dmsc/my6502/simulator/README.md

Simulator for my6502 computer
=============================

This simulator allows testing the target firmware, should support all the
standard hardware implemented by the FPGA.

The UART is connected to the standard input/output and the VGA output is
written to an image file.
