dmsc/my6502/rtl/timer.v

/*
 * Simple 6502 computer for ice40up5k FPGA.
 *
 * (C) Daniel Serpell, <daniel.serpell@gmail.com>
 *
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
 */

// Simple 16 bit timer

module timer(
    output reg [7:0] dbr,   // Data bus READ
    input  [7:0] dbw,   // Data bus WRITE
    input  [1:0] addr,  // Address bus - two bits
    input  we,          // write/read
    input  rst,         // reset
    input  clk          // Clock
    );


    reg [15:0] counter; // Timer count
    reg active;         // Timer active
    reg shot;           // Timer reached count (reset on timer write)
    wire chip_write = we;

    // main process
    always @(posedge clk or posedge rst)
    begin
        if (rst)
        begin
            counter <= 0;
            shot <= 0;
            active <= 0;
        end
        else
        begin
            // Process writes to registers
            if (chip_write)
            begin
                // NOTE: writing to any register here will inhibit the
                //       decrementing bellow, so we loose two cycles for each
                //       counter update and one for updating the one-shot
                case(addr)
                    2'b00: counter <= counter + { 8'b0, dbw };
                    2'b01: counter <= counter + { dbw, 8'b0 };
                    2'b10:
                    begin
                        shot <= dbw[7];
                        active <= dbw[0];
                        if (dbw[0] == 0) // When timer de-activates, the count is reset to 0
                            counter <= 0;
                    end
                endcase
            end
            else
            begin
                // Process timer - only when not written
                if (active)
                begin
                    counter <= counter - 1;
                    if (counter == 0)
                        shot <= 1;
                end

                // Process reads
                case(addr)
                    2'b00: dbr <= { counter[7:0] };
                    2'b01: dbr <= { counter[15:8] };
                    2'b10: dbr <= { shot, 6'b0, active };
                endcase
            end
        end
    end

endmodule
