dmsc/my6502/rtl/upduino.v

/*
 * Simple 6502 computer for ice40up5k FPGA.
 *
 * (C) Daniel Serpell, <daniel.serpell@gmail.com>
 *
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
 */

// ICE40UP implementation details

module upduino(
    input  uart_rx,
    output uart_tx,
    output led_r,
    output led_g,
    output led_b,
    output vga_h,
    output vga_v,
    output vga_r,
    output vga_g,
    output vga_b,
    output vga_i,
    inout  spi0_mosi,
    inout  spi0_miso,
    inout  spi0_sclk,
    inout  spi0_cs0,
    inout  ps2_data,
    inout  ps2_clock,
    input  iclk
    );

    wire clk25;
    wire lock;

    // Main clock from PLL
    pll pll1(
        .clock_in(iclk),
        .clock_out(clk25),
        .locked(lock)
    );

    system #(
        .CLK_HZ(25175000)
    ) sys1 (
        .clk25(clk25),
        .rst(reset),
        .uart_tx(uart_tx),
        .uart_rx(uart_rx),
        .led_r(led_r),
        .led_g(led_g),
        .led_b(led_b),
        .spi0_mosi(spi0_mosi),
        .spi0_miso(spi0_miso),
        .spi0_sclk(spi0_sclk),
        .spi0_cs0(spi0_cs0),
        .ps2_data(ps2_data),
        .ps2_clock(ps2_clock),
        .vga_h(vga_h),
        .vga_v(vga_v),
        .vga_r(vga_r),
        .vga_g(vga_g),
        .vga_b(vga_b),
        .vga_i(vga_i)
    );

    reg [3:0] cdiv = 4'b0;
    reg reset = 1;
    always @(posedge clk25)
    begin
        if (lock)
        begin
            cdiv <= cdiv + 1;
            if(cdiv == 4'b1111)
                reset <= 0;
        end
    end

endmodule
