dmsc/my6502/simulator/src/sim65.c

/*
 * Mini65 - Small 6502 simulator with Atari 8bit bios.
 * Copyright (C) 2017-2019 Daniel Serpell
 *
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
 * You should have received a copy of the GNU General Public License along
 * with this program.  If not, see <http://www.gnu.org/licenses/>
 */
#include "sim65.h"
#include "likely.h"
#include <inttypes.h>
#include <stdarg.h>
#include <stdint.h>
#include <stdio.h>
#include <stdlib.h>
#include <string.h>

#define MAXRAM (0x10000)

// Memory status codes
#define ms_undef    1
#define ms_rom      2
#define ms_invalid  4
#define ms_callback 8

// Instruction lengths
static uint8_t ilen[256] = {
    1,2,1,1,1,2,2,1,1,2,1,1,1,3,3,1, 2,2,1,1,1,2,2,1,1,3,1,1,1,3,3,1,
    3,2,1,1,2,2,2,1,1,2,1,1,3,3,3,1, 2,2,1,1,1,2,2,1,1,3,1,1,1,3,3,1,
    1,2,1,1,1,2,2,1,1,2,1,1,3,3,3,1, 2,2,1,1,1,2,2,1,1,3,1,1,1,3,3,1,
    1,2,1,1,1,2,2,1,1,2,1,1,3,3,3,1, 2,2,1,1,1,2,2,1,1,3,1,1,1,3,3,1,
    1,2,1,1,2,2,2,1,1,1,1,1,3,3,3,1, 2,2,1,1,2,2,2,1,1,3,1,1,1,3,1,1,
    2,2,2,1,2,2,2,1,1,2,1,1,3,3,3,1, 2,2,1,1,2,2,2,1,1,3,1,1,3,3,3,1,
    2,2,1,1,2,2,2,1,1,2,1,1,3,3,3,1, 2,2,1,1,1,2,2,1,1,3,1,1,1,3,3,1,
    2,2,1,1,2,2,2,1,1,2,1,1,3,3,3,1, 2,2,1,1,1,2,2,1,1,3,1,1,1,3,3,1
};

struct sim65s
{
    enum sim65_debug debug;
    enum sim65_error error;
    enum sim65_error_lvl errlvl;
    FILE *trace_file;
    unsigned err_addr;
    uint64_t cycles;
    uint64_t cycle_limit;
    unsigned do_prof;
    struct sim65_reg r;
    uint8_t p_valid;
    uint8_t mem[MAXRAM];
    uint8_t mems[MAXRAM];
    sim65_callback cb_read[MAXRAM];
    sim65_callback cb_write[MAXRAM];
    sim65_callback cb_exec[MAXRAM];
    struct {
        unsigned exe[MAXRAM];   // Times this instruction was executed
        unsigned branch[MAXRAM];// Times this branch was taken
        unsigned branch_skip;   // Number of branches skipped
        unsigned branch_taken;  // Number of branches taken
        unsigned branch_extra;  // Extra cycles per branch to other page
        unsigned abs_x_extra;   // Extra cycles per ABS,X crossing page
        unsigned abs_y_extra;   // Extra cycles per ABS,Y crossing page
        unsigned ind_y_extra;   // Extra cycles per (),Y crossing page
        unsigned instructions;  // Number of instructions
    } prof;
    char *labels;
};

// Check if we should exit given this error, or simply log it
static int get_error_exit(sim65 s)
{
    int e = 0;
    switch (s->error)
    {
        case sim65_err_none:
            // Never exit and don't print the error
            return 0;
        case sim65_err_read_uninit:
        case sim65_err_write_rom:
            e = (s->errlvl >= sim65_errlvl_full);
            break;
        case sim65_err_exec_uninit:
        case sim65_err_read_undef:
        case sim65_err_write_undef:
            e = (s->errlvl >= sim65_errlvl_memory);
            break;
        case sim65_err_exec_undef:
        case sim65_err_break:
        case sim65_err_invalid_ins:
        case sim65_err_call_ret:
        case sim65_err_cycle_limit:
        case sim65_err_user:
            // Exit always
            return 1;
    }
    if (!e)
    {
        sim65_dprintf(s, "%s at address %04x", sim65_error_str(s, s->error),
                      s->err_addr);
        s->error = sim65_err_none;
        return 0;
    }
    else
        return s->error;
}

static char *get_label(sim65 s, uint16_t addr)
{
    if (s->labels)
        return s->labels + addr * 32;
    else
        return 0;
}

static void set_flags(sim65 s, uint8_t mask, uint8_t val)
{
    s->r.p = (s->r.p & ~mask) | val;
    s->p_valid &= ~mask;
}

static uint8_t get_flags(sim65 s, uint8_t mask)
{
    if( 0 != (s->p_valid & mask) )
        sim65_eprintf(s, "using uninitialized flags ($%02X) at PC=$%4X",
                      s->p_valid & mask, s->r.pc);
    return s->r.p & mask;
}

void sim65_set_flags(sim65 s, uint8_t flag, uint8_t val)
{
    set_flags(s, flag, val);
}

void sim65_set_cycle_limit(sim65 s, uint64_t limit)
{
    if (limit)
        s->cycle_limit = s->cycles + limit;
    else
        s->cycle_limit = 0;
}

sim65 sim65_new()
{
    sim65 s = (sim65)calloc(sizeof(struct sim65s), 1);
    s->trace_file = stderr;
    s->r.s = 0xFF;
    s->p_valid = 0xFF;
    set_flags(s, 0xFF, 0x34);
    memset(s->mems, ms_undef | ms_invalid, MAXRAM * sizeof(s->mems[0]));
    return s;
}

void sim65_free(sim65 s)
{
    free(s->labels);
    free(s);
}

void sim65_add_ram(sim65 s, unsigned addr, unsigned len)
{
    unsigned end = addr + len;
    if (addr >= MAXRAM)
        return;
    if (end >= MAXRAM)
        end = MAXRAM;
    for (; addr < end; addr++)
        s->mems[addr] &= ~ms_undef;
}

void sim65_add_zeroed_ram(sim65 s, unsigned addr, unsigned len)
{
    unsigned end = addr + len;
    if (addr >= MAXRAM)
        return;
    if (end >= MAXRAM)
        end = MAXRAM;
    for (; addr < end; addr++)
    {
        s->mems[addr] &= ~(ms_undef | ms_rom | ms_invalid);
        s->mem[addr] = 0;
    }
}

void sim65_add_data_ram(sim65 s, unsigned addr, const unsigned char *data, unsigned len)
{
    unsigned end = addr + len;
    if (addr >= MAXRAM)
        return;
    if (end >= MAXRAM)
        end = MAXRAM;
    for (; addr < end; addr++, data++)
    {
        s->mems[addr] &= ~(ms_undef | ms_rom | ms_invalid);
        s->mem[addr] = *data;
    }
}

void sim65_add_data_rom(sim65 s, unsigned addr, const unsigned char *data, unsigned len)
{
    unsigned end = addr + len;
    if (addr >= MAXRAM)
        return;
    if (end >= MAXRAM)
        end = MAXRAM;
    for (; addr < end; addr++, data++)
    {
        s->mems[addr] &= ~(ms_undef | ms_invalid);
        s->mems[addr] |= ms_rom;
        s->mem[addr] = *data;
    }
}

void sim65_add_callback(sim65 s, unsigned addr, sim65_callback cb, enum sim65_cb_type type)
{
    if (addr >= MAXRAM)
        return;
    s->mems[addr] |= ms_callback;
    switch (type)
    {
        case sim65_cb_read:
            s->cb_read[addr] = cb;
            break;
        case sim65_cb_write:
            s->cb_write[addr] = cb;
            break;
        case sim65_cb_exec:
            s->cb_exec[addr] = cb;
            break;
    }
}

void sim65_add_callback_range(sim65 s, unsigned addr, unsigned len, sim65_callback cb,
                              enum sim65_cb_type type)
{
    unsigned i;
    for (i = addr; i < addr + len && i < MAXRAM; i++)
        sim65_add_callback(s, i, cb, type);
}

unsigned sim65_get_byte(sim65 s, unsigned addr)
{
    if (addr >= MAXRAM)
        return 0x100;
    if (s->mems[addr] & ms_invalid)
        return 0x100;
    return s->mem[addr];
}

uint8_t *sim65_get_pbyte(sim65 s, unsigned addr)
{
    if (addr >= MAXRAM)
        return 0;
    return & s->mem[addr];
}

void set_error(sim65 s, int e, uint16_t addr)
{
    if (e < 0 && !s->error)
    {
        s->error = (enum sim65_error)e;
        s->err_addr = addr;
    }
}

static uint8_t readPc_slow(sim65 s, uint16_t addr)
{
    if (s->mems[addr] & ms_undef)
        set_error(s, sim65_err_exec_undef, addr);
    else
        set_error(s, sim65_err_exec_uninit, addr);
    return s->mem[addr];
}

static inline uint8_t readPc(sim65 s, unsigned offset)
{
    uint16_t addr = s->r.pc + offset;
    return likely(!(s->mems[addr] & ~(ms_rom | ms_callback))) ?
           s->mem[addr] : readPc_slow(s, addr);
}

static uint8_t readByte_slow(sim65 s, uint16_t addr)
{
    // Unusual memory
    if ((s->mems[addr] & ms_callback) && s->cb_read[addr])
    {
        int e = s->cb_read[addr](s, &s->r, addr, sim65_cb_read);
        set_error(s, e, addr);
        return e;
    }
    else
    {
        if (s->mems[addr] & ms_undef)
            set_error(s, sim65_err_read_undef, addr);
        else
        {
            set_error(s, sim65_err_read_uninit, addr);
            s->mems[addr] &= ~ms_invalid; // Initializes the memory
        }
        return s->mem[addr];
    }
}

static inline uint8_t readByte(sim65 s, uint16_t addr)
{
    return likely(!(s->mems[addr] & ~ms_rom)) ? s->mem[addr] : readByte_slow(s, addr);
}

static void writeByte_slow(sim65 s, uint16_t addr, uint8_t val)
{
    if (likely(!(s->mems[addr] & ~ms_invalid)))
    {
        s->mem[addr] = val;
        s->mems[addr] = 0;
    }
    else if ((s->mems[addr] & ms_callback) && s->cb_write[addr])
        set_error(s, s->cb_write[addr](s, &s->r, addr, val), addr);
    else if (s->mems[addr] & ms_undef)
        set_error(s, sim65_err_write_undef, addr);
    else if (s->mems[addr] & ms_rom)
        set_error(s, sim65_err_write_rom, addr);
}

static inline void writeByte(sim65 s, uint16_t addr, uint8_t val)
{
    if (likely(!(s->mems[addr])))
        s->mem[addr] = val;
    else
        writeByte_slow(s, addr, val);
}

static inline uint16_t readWord(sim65 s, uint16_t addr)
{
    uint16_t d1 = readByte(s, addr);
    return d1 | (readByte(s, addr + 1) << 8);
}

static uint8_t readIndX(sim65 s, unsigned addr)
{
    s->cycles += 6;
    addr = readWord(s, (addr + s->r.x) & 0xFF);
    return readByte(s, addr);
}

static int readIndY(sim65 s, unsigned addr)
{
    s->cycles += 5;
    addr = readWord(s, addr & 0xFF);
    if (unlikely(((addr & 0xFF) + s->r.y) > 0xFF))
    {
        s->cycles++;
        if (s->do_prof)
            s->prof.ind_y_extra ++;
    }
    return readByte(s, 0xFFFF & (addr + s->r.y));
}

static void writeIndX(sim65 s, unsigned addr, unsigned val)
{
    s->cycles += 6;
    addr = readWord(s, (addr + s->r.x) & 0xFF);
    writeByte(s, addr, val);
}

static void writeIndY(sim65 s, unsigned addr, unsigned val)
{
    s->cycles += 6;
    addr = readWord(s, addr & 0xFF);
    writeByte(s, 0xFFFF & (addr + s->r.y), val);
}

#define FLAG_C SIM65_FLAG_C
#define FLAG_Z SIM65_FLAG_Z
#define FLAG_I SIM65_FLAG_I
#define FLAG_D SIM65_FLAG_D
#define FLAG_B SIM65_FLAG_B
#define FLAG_V SIM65_FLAG_V
#define FLAG_N SIM65_FLAG_N

#define SETZ(a) set_flags(s, FLAG_Z,  (a)&0xFF ? 0 : FLAG_Z)
#define SETC(a) set_flags(s, FLAG_C,  (a) ? FLAG_C : 0)
#define SETV(a) set_flags(s, FLAG_V,  (a) ? FLAG_V : 0)
#define SETD(a) set_flags(s, FLAG_D,  (a) ? FLAG_D : 0)
#define SETN(a) set_flags(s, FLAG_N,  (a)&0x80 ? FLAG_N : 0)
#define SETI(a) set_flags(s, FLAG_I,  (a) ? FLAG_I : 0)
#define GETC    get_flags(s, FLAG_C)
#define GETD    get_flags(s, FLAG_D)

// Implements ADC instruction, adding the accumulator with the given value.
static void do_adc(sim65 s, unsigned val)
{
    if (GETD)
    {
        // Decimal mode:
        // Z flag is computed as the binary version.
        unsigned tmp = s->r.a + val + (GETC ? 1 : 0);
        SETZ(tmp);
        // ADC value is computed in decimal
        tmp = (s->r.a & 0xF) + (val & 0xF) + (GETC ? 1 : 0);
        if (tmp >= 10)
            tmp = (tmp - 10) | 16;
        tmp += (s->r.a & 0xF0) + (val & 0xF0);
        SETN(tmp);
        SETV(!((s->r.a ^ val) & 0x80) && ((val ^ tmp) & 0x80));
        if (tmp > 0x9F)
            tmp += 0x60;
        SETC(tmp > 0xFF);
        s->r.a = tmp & 0xFF;
    }
    else
    {
        // Binary mode
        unsigned tmp = s->r.a + val + (GETC ? 1 : 0);
        SETV(((~(s->r.a ^ val)) & (s->r.a ^ tmp)) & 0x80);
        //  SETV(!((s->r.a ^ val) & 0x80) && ((val ^ tmp) & 0x80));
        SETC(tmp > 0xFF);
        SETN(tmp);
        SETZ(tmp);
        s->r.a = tmp & 0xFF;
    }
}

// Implements SBC instruction, subtract the accumulator to the given value.
static void do_sbc(sim65 s, unsigned val)
{
    if (GETD)
    {
        // Decimal mode:
        val = val ^ 0xFF;

        // Z and V flags computed as the binary version.
        unsigned tmp = s->r.a + val + (GETC ? 1 : 0);
        SETV((((s->r.a ^ val)) & (s->r.a ^ tmp)) & 0x80);
        SETZ(tmp);

        // ADC value is computed in decimal
        tmp = (s->r.a & 0xF) + (val & 0xF) + (GETC ? 1 : 0);
        if (tmp < 0x10)
            tmp = (tmp - 6) & 0x0F;

        tmp += (s->r.a & 0xF0) + (val & 0xF0);
        if (tmp < 0x100)
            tmp = (tmp - 0x60) & 0xFF;

        SETN(tmp);
        SETC(tmp > 0xFF);
        s->r.a = tmp & 0xFF;
    }
    else
    {
        // Binary mode
        unsigned tmp = s->r.a + 0xFF - val + (GETC ? 1 : 0);
        SETV((((s->r.a ^ val)) & (s->r.a ^ tmp)) & 0x80);
        SETC(tmp > 0xFF);
        SETN(tmp);
        SETZ(tmp);
        s->r.a = tmp & 0xFF;
    }
}

// Implements branch instructions
static void do_branch(sim65 s, int8_t off, uint8_t mask, int cond)
{
    s->cycles += 2;
    if (!get_flags(s, mask) == !cond)
    {
        s->cycles++;
        if (s->do_prof)
        {
            s->prof.branch[(s->r.pc-2) & 0xFFFF] ++;
            s->prof.branch_taken ++;
        }
        uint16_t val = (s->r.pc + off) & 0xFFFF;
        if ((val & 0xFF00) != (s->r.pc & 0xFF00))
        {
            s->cycles++;
            if (s->do_prof)
                s->prof.branch_extra ++;
        }
        s->r.pc = val;
    }
    else if (s->do_prof)
        s->prof.branch_skip ++;
}

static void do_extra_absx(sim65 s, unsigned addr)
{
    if (((addr & 0xFF) + s->r.x) > 0xFF)
    {
        s->cycles++;
        if (s->do_prof)
            s->prof.abs_x_extra ++;
    }
}

static void do_extra_absy(sim65 s, unsigned addr)
{
    if (((addr & 0xFF) + s->r.y) > 0xFF)
    {
        s->cycles++;
        if (s->do_prof)
            s->prof.abs_y_extra ++;
    }
}

#define ZP_R1   val = readByte(s, data & 0xFF)
#define ZP_W1   writeByte(s, data & 0xFF, val)
#define ZPX_R1  val = readByte(s, (data + s->r.x) & 0xFF)
#define ZPX_W1  writeByte(s, (data + s->r.x) & 0xFF, val)
#define ZPY_R1  val = readByte(s, (data + s->r.y) & 0xFF)
#define ZPY_W1  writeByte(s, (data + s->r.y) & 0xFF, val)
#define ABS_R1  val = readByte(s, data)
#define ABS_W1  writeByte(s, data, val)
#define ABX_R1  val = readByte(s, data + s->r.x)
#define ABX_W1  writeByte(s, data + s->r.x, val)
#define ABY_R1  val = readByte(s, data + s->r.y)
#define ABY_W1  writeByte(s, data + s->r.y, val)
#define IND_X(op)  val = readIndX(s, data); op
#define IND_Y(op)  val = readIndY(s, data); op
#define INDW_X(op) op; writeIndX(s, data, val)
#define INDW_Y(op) op; writeIndY(s, data, val)

#define ORA s->r.a |= val; SETZ(s->r.a); SETN(s->r.a)
#define AND s->r.a &= val; SETZ(s->r.a); SETN(s->r.a)
#define EOR s->r.a ^= val; SETZ(s->r.a); SETN(s->r.a)
#define ADC do_adc(s, val)
#define SBC do_sbc(s, val)
#define ASL SETC(val & 0x80); val = (val << 1) & 0xFF; SETZ(val); SETN(val)
#define ROL val = (val << 1) | (GETC ? 1 : 0); SETC(val & 256); val &= 0xFF; SETZ(val); SETN(val)
#define LSR SETC(val & 1); val=(val >> 1) & 0xFF; SETZ(val); SETN(val)
#define ROR val |= (GETC ? 256 : 0); SETC(val & 1); val = (val >> 1) & 0xFF; SETZ(val); SETN(val)

#define SET_ZN   SETN(val); SETZ(val)
#define DEC val = (val - 1) & 0xFF; SET_ZN
#define INC val = (val + 1) & 0xFF; SET_ZN
#define CMP val = (s->r.a + 0x100 - val); SET_ZN; SETC(val > 0xFF)
#define CPX val = (s->r.x + 0x100 - val); SET_ZN; SETC(val > 0xFF)
#define CPY val = (s->r.y + 0x100 - val); SET_ZN; SETC(val > 0xFF)

#define LDA SET_ZN; s->r.a = val
#define LDX SET_ZN; s->r.x = val
#define LDY SET_ZN; s->r.y = val
#define STA val = s->r.a
#define STX val = s->r.x
#define STY val = s->r.y
#define PUSH(val) s->cycles += 3; writeByte(s, 0x100 + s->r.s,val); s->r.s = (s->r.s - 1) & 0xFF
#define POP  s->r.s = (s->r.s + 1) & 0xFF; val = readByte(s, 0x100 + s->r.s)

// Complete ops
#define ZP_R(op)   s->cycles += 3; ZP_R1; op
#define ZP_W(op)   s->cycles += 3; op; ZP_W1
#define ZP_RW(op)  s->cycles += 5; ZP_R1; op; ZP_W1

#define ABS_R(op)  s->cycles += 4; ABS_R1; op
#define ABS_W(op)  s->cycles += 4; op; ABS_W1
#define ABS_RW(op) s->cycles += 6; ABS_R1; op; ABS_W1

#define ZPX_R(op)   s->cycles += 4; ZPX_R1; op
#define ZPX_W(op)   s->cycles += 4; op; ZPX_W1
#define ZPX_RW(op)  s->cycles += 6; ZPX_R1; op; ZPX_W1

#define ZPY_R(op)   s->cycles += 4; ZPY_R1; op
#define ZPY_W(op)   s->cycles += 4; op; ZPY_W1

#define ABX_R(op)   s->cycles += 4; do_extra_absx(s, data); ABX_R1; op
#define ABX_W(op)   s->cycles += 5; op; ABX_W1
#define ABX_RW(op)  s->cycles += 7; ABX_R1; op; ABX_W1

#define ABY_R(op)   s->cycles += 4; do_extra_absy(s, data); ABY_R1; op
#define ABY_W(op)   s->cycles += 5; op; ABY_W1

#define IMM(op)     s->cycles += 2; val = data; op
#define IMP_A(op)   s->cycles += 2; val = s->r.a; op; s->r.a = val; SET_ZN
#define IMP_Y(op)   s->cycles += 2; val = s->r.y; op; s->r.y = val; SET_ZN
#define IMP_X(op)   s->cycles += 2; val = s->r.x; op; s->r.x = val; SET_ZN
#define TXS(op)     s->cycles += 2; s->r.s = s->r.x;

#define BRA_0(a)    do_branch(s, data, a, 0)
#define BRA_1(a)    do_branch(s, data, a, 1)
#define JMP()      s->cycles += 3; s->r.pc = data
#define JMP16()    s->cycles += 5; s->r.pc = readWord(s, data)
#define JSR()      do_jsr(s, data)
#define RTS()      do_rts(s)
#define RTI()      do_rti(s)

#define CL_F(f)   s->cycles += 2; set_flags(s, f, 0)
#define SE_F(f)   s->cycles += 2; set_flags(s, f, f)

#define POP_P  s->cycles += 4; POP; set_flags(s, 0xFF, val | 0x30)
#define POP_A  s->cycles += 4; POP; LDA

// Special case BIT instructions as sometimes are used to SKIP
void do_bit(sim65 s, uint16_t addr)
{
    if ((s->mems[addr] & ms_invalid) && !(s->mems[addr] & ms_callback))
        s->p_valid |= (FLAG_N | FLAG_V | FLAG_Z);
    else
    {
        uint8_t val = readByte(s, addr);
        SETN(val);
        SETV(val & 0x40);
        SETZ(s->r.a & val);
    }
}
#define BIT_ZP   s->cycles += 3; do_bit(s, data & 0xFF)
#define BIT_ABS  s->cycles += 4; do_bit(s, data)

static void do_jsr(sim65 s, unsigned data)
{
    s->r.pc = (s->r.pc - 1) & 0xFFFF;
    PUSH(s->r.pc >> 8);
    PUSH(s->r.pc);
    s->r.pc = data;
}

static void do_rts(sim65 s)
{
    unsigned val;
    POP;
    s->r.pc = val;
    POP;
    s->r.pc |= val << 8;
    s->r.pc = (s->r.pc + 1) & 0xFFFF;
    s->cycles += 6;
}

static void do_rti(sim65 s)
{
    unsigned val;
    POP_P; // NOTE: already adds 4 cycles
    POP;
    s->r.pc = val;
    POP;
    s->r.pc |= val << 8;
    s->r.pc = (s->r.pc) & 0xFFFF;
    s->cycles += 2;
}

static void next(sim65 s)
{
    unsigned ins, data, val, old_pc = 0, old_cycles = 0;

    // See if out vector
    if (s->cb_exec[s->r.pc])
    {
        set_error(s, s->cb_exec[s->r.pc](s, &s->r, s->r.pc, sim65_cb_exec), s->r.pc);
        if (get_error_exit(s))
            return;
    }

    if (s->debug >= sim65_debug_trace)
        sim65_print_reg(s, s->trace_file);

    if (s->cycle_limit && s->cycles >= s->cycle_limit)
    {
        set_error(s, sim65_err_cycle_limit, s->r.pc);
        return;
    }

    // Read instruction and data
    ins = readPc(s, 0);
    if (ilen[ins] > 1)
        data = readPc(s, 1);

    if (ilen[ins] > 2)
        data |= readPc(s, 2) << 8;

    // If profiling, store old info
    if (s->do_prof)
    {
        old_pc = s->r.pc;
        old_cycles = s->cycles;
    }
    // Update PC
    s->r.pc += ilen[ins];

    switch (ins)
    {
        case 0x00:  set_error(s, sim65_err_break, s->r.pc - 1); break;
        case 0x01:  IND_X(ORA);             break;
        case 0x05:  ZP_R(ORA);              break;
        case 0x06:  ZP_RW(ASL);             break;
        case 0x08:  PUSH(get_flags(s,0xFF)); break; // PHP
        case 0x09:  IMM(ORA);               break;
        case 0x0A:  IMP_A(ASL);             break;
        case 0x0D:  ABS_R(ORA);             break;
        case 0x0E:  ABS_RW(ASL);            break;
        case 0x10:  BRA_0(FLAG_N);          break; // BPL
        case 0x11:  IND_Y(ORA);             break;
        case 0x15:  ZPX_R(ORA);             break;
        case 0x16:  ZPX_RW(ASL);            break;
        case 0x18:  CL_F(FLAG_C);           break; // CLC
        case 0x19:  ABY_R(ORA);             break;
        case 0x1d:  ABX_R(ORA);             break;
        case 0x1e:  ABX_RW(ASL);            break;
        case 0x20:  JSR();                  break; // JSR
        case 0x21:  IND_X(AND);             break;
        case 0x24:  BIT_ZP;                 break;
        case 0x25:  ZP_R(AND);              break;
        case 0x26:  ZP_RW(ROL);             break;
        case 0x28:  POP_P;                  break; // PLP
        case 0x29:  IMM(AND);               break;
        case 0x2a:  IMP_A(ROL);             break;
        case 0x2c:  BIT_ABS;                break;
        case 0x2d:  ABS_R(AND);             break;
        case 0x2e:  ABS_RW(ROL);            break;
        case 0x30:  BRA_1(FLAG_N);          break;
        case 0x31:  IND_Y(AND);             break;
        case 0x35:  ZPX_R(AND);             break;
        case 0x36:  ZPX_RW(ROL);            break;
        case 0x38:  SE_F(FLAG_C);           break; // SEC
        case 0x39:  ABY_R(AND);             break;
        case 0x3d:  ABX_R(AND);             break;
        case 0x3e:  ABX_RW(ROL);            break;
        case 0x40:  RTI();                  break; // RTI
        case 0x41:  IND_X(EOR);             break;
        case 0x45:  ZP_R(EOR);              break;
        case 0x46:  ZP_RW(LSR);             break;
        case 0x48:  PUSH(s->r.a);           break; // PHA
        case 0x49:  IMM(EOR);               break;
        case 0x4a:  IMP_A(LSR);             break;
        case 0x4c:  JMP();                  break; // JMP
        case 0x4d:  ABS_R(EOR);             break;
        case 0x4e:  ABS_RW(LSR);            break;
        case 0x50:  BRA_0(FLAG_V);          break;
        case 0x51:  IND_Y(EOR);             break;
        case 0x55:  ZPX_R(EOR);             break;
        case 0x56:  ZPX_RW(LSR);            break;
        case 0x58:  CL_F(FLAG_I);           break; // CLI
        case 0x59:  ABY_R(EOR);             break;
        case 0x5d:  ABX_R(EOR);             break;
        case 0x5e:  ABX_RW(LSR);            break;
        case 0x60:  RTS();                  break; // RTS
        case 0x61:  IND_X(ADC);             break;
        case 0x65:  ZP_R(ADC);              break;
        case 0x66:  ZP_RW(ROR);             break;
        case 0x68:  POP_A;                  break; // PLA
        case 0x69:  IMM(ADC);               break;
        case 0x6a:  IMP_A(ROR);             break;
        case 0x6c:  JMP16();                break; // JMP ()
        case 0x6d:  ABS_R(ADC);             break;
        case 0x6e:  ABS_RW(ROR);            break;
        case 0x70:  BRA_1(FLAG_V);          break;
        case 0x71:  IND_Y(ADC);             break;
        case 0x75:  ZPX_R(ADC);             break;
        case 0x76:  ZPX_RW(ROR);            break;
        case 0x78:  SE_F(FLAG_I);           break; // SEI
        case 0x79:  ABY_R(ADC);             break;
        case 0x7d:  ABX_R(ADC);             break;
        case 0x7e:  ABX_RW(ROR);            break;
        case 0x81:  INDW_X(STA);            break;
        case 0x84:  ZP_W(STY);              break;
        case 0x85:  ZP_W(STA);              break;
        case 0x86:  ZP_W(STX);              break;
        case 0x88:  IMP_Y(DEC);             break; // DEY
        case 0x8a:  IMP_X(LDA);             break; // TXA
        case 0x8c:  ABS_W(STY);             break;
        case 0x8d:  ABS_W(STA);             break;
        case 0x8e:  ABS_W(STX);             break;
        case 0x90:  BRA_0(FLAG_C);          break; // BCC
        case 0x91:  INDW_Y(STA);            break;
        case 0x94:  ZPX_W(STY);             break;
        case 0x95:  ZPX_W(STA);             break;
        case 0x96:  ZPY_W(STX);             break;
        case 0x98:  IMP_Y(LDA);             break; // TYA
        case 0x99:  ABY_W(STA);             break;
        case 0x9a:  TXS();                  break; // TXS
        case 0x9d:  ABX_W(STA);             break;
        case 0xa0:  IMM(LDY);               break;
        case 0xa1:  IND_X(LDA);             break;
        case 0xa2:  IMM(LDX);               break;
        case 0xa4:  ZP_R(LDY);              break;
        case 0xa5:  ZP_R(LDA);              break;
        case 0xa6:  ZP_R(LDX);              break;
        case 0xa8:  IMP_A(LDY);             break; // TAY
        case 0xa9:  IMM(LDA);               break;
        case 0xaa:  IMP_A(LDX);             break; // TAX
        case 0xac:  ABS_R(LDY);             break;
        case 0xad:  ABS_R(LDA);             break;
        case 0xae:  ABS_R(LDX);             break;
        case 0xb0:  BRA_1(FLAG_C);          break; // BCS
        case 0xb1:  IND_Y(LDA);             break;
        case 0xb4:  ZPX_R(LDY);             break;
        case 0xb5:  ZPX_R(LDA);             break;
        case 0xb6:  ZPY_R(LDX);             break;
        case 0xb8:  CL_F(FLAG_V);           break; // CLV
        case 0xb9:  ABY_R(LDA);             break;
        case 0xba:  IMP_X(val = s->r.s);    break; // TSX
        case 0xbc:  ABX_R(LDY);             break;
        case 0xbd:  ABX_R(LDA);             break;
        case 0xbe:  ABY_R(LDX);             break;
        case 0xc0:  IMM(CPY);               break;
        case 0xc1:  IND_X(CMP);             break;
        case 0xc4:  ZP_R(CPY);              break;
        case 0xc5:  ZP_R(CMP);              break;
        case 0xc6:  ZP_RW(DEC);             break;
        case 0xc8:  IMP_Y(INC);             break; // INY
        case 0xc9:  IMM(CMP);               break;
        case 0xca:  IMP_X(DEC);             break; // DEX
        case 0xcc:  ABS_R(CPY);             break;
        case 0xcd:  ABS_R(CMP);             break;
        case 0xce:  ABS_RW(DEC);            break;
        case 0xd0:  BRA_0(FLAG_Z);          break; // BNE
        case 0xd1:  IND_Y(CMP);             break;
        case 0xd5:  ZPX_R(CMP);             break;
        case 0xd6:  ZPX_RW(DEC);            break;
        case 0xd8:  CL_F(FLAG_D);           break; // CLD
        case 0xd9:  ABY_R(CMP);             break;
        case 0xdd:  ABX_R(CMP);             break;
        case 0xde:  ABX_RW(DEC);            break;
        case 0xe0:  IMM(CPX);               break;
        case 0xe1:  IND_X(SBC);             break;
        case 0xe4:  ZP_R(CPX);              break;
        case 0xe5:  ZP_R(SBC);              break;
        case 0xe6:  ZP_RW(INC);             break;
        case 0xe8:  IMP_X(INC);             break; // INX
        case 0xe9:  IMM(SBC);               break;
        case 0xea:  s->cycles += 2;         break; // NOP
        case 0xec:  ABS_R(CPX);             break;
        case 0xed:  ABS_R(SBC);             break;
        case 0xee:  ABS_RW(INC);            break;
        case 0xf0:  BRA_1(FLAG_Z);          break; // BEQ
        case 0xf1:  IND_Y(SBC);             break;
        case 0xf5:  ZPX_R(SBC);             break;
        case 0xf6:  ZPX_RW(INC);            break;
        case 0xf8:  SE_F(FLAG_D);           break; // SED
        case 0xf9:  ABY_R(SBC);             break;
        case 0xfd:  ABX_R(SBC);             break;
        case 0xfe:  ABX_RW(INC);            break;
        default:    set_error(s, sim65_err_invalid_ins, s->r.pc - 1);
    }
    // Update profile information
    if (s->do_prof)
    {
        s->prof.instructions ++;
        s->prof.exe[old_pc & 0xFFFF] += s->cycles -old_cycles;
    }
}

enum sim65_error sim65_run(sim65 s, struct sim65_reg *regs, unsigned addr)
{
    if (regs)
        memcpy(&s->r, regs, sizeof(*regs));

    s->error = sim65_err_none;
    s->r.pc = addr;
    while (!get_error_exit(s))
        next(s);

    if (regs)
        memcpy(regs, &s->r, sizeof(*regs));

    return s->error;
}

// Called on return from simulated code
static int sim65_rts_callback(sim65 s, struct sim65_reg *regs,
                              unsigned addr, int data)
{
    return (int)sim65_err_call_ret;
}

// Calls the emulator at given code, ends on RTS
enum sim65_error sim65_call(sim65 s, struct sim65_reg *regs, unsigned addr)
{
    // Setup registers if given
    if (regs)
        memcpy(&s->r, regs, sizeof(*regs));

    // Save original PC
    unsigned old_pc = s->r.pc;

    // Use 0 as return address
    s->r.pc = 0;
    sim65_add_callback(s, 0, sim65_rts_callback, sim65_cb_exec);

    // Execute a JSR
    do_jsr(s, addr);

    // And continue the emulator
    enum sim65_error err = sim65_run(s, 0, addr);

    // If we got from a JSR return, simply return ok
    if (err == sim65_err_call_ret)
    {
        // Now, return to old address
        s->r.pc = old_pc;
        err = s->error = sim65_err_none;
    }

    return err;
}

void sim65_set_debug(sim65 s, enum sim65_debug level)
{
    s->debug = level;
}

void sim65_set_trace_file(sim65 s, FILE *f)
{
    if (f)
        s->trace_file = f;
    else
        s->trace_file = stderr;
}

void sim65_set_error_level(sim65 s, enum sim65_error_lvl level)
{
    s->errlvl = level;
}

// --------------------------------------------------------------------
// Trace printing functions
// --------------------------------------------------------------------
static const char *hex_digits = "0123456789ABCDEF";
static char *hex2(char *c, uint8_t x)
{
    c[0] = hex_digits[x >> 4];
    c[1] = hex_digits[x & 15];
    return c + 2;
}

static char *hex4(char *c, uint16_t x)
{
    c[0] = hex_digits[x >> 12];
    c[1] = hex_digits[(x >> 8) & 15];
    c[2] = hex_digits[(x >> 4) & 15];
    c[3] = hex_digits[x & 15];
    return c + 4;
}

static char *hex8(char *c, uint32_t x)
{
    c[0] = hex_digits[(x >> 28) & 15];
    c[1] = hex_digits[(x >> 24) & 15];
    c[2] = hex_digits[(x >> 20) & 15];
    c[3] = hex_digits[(x >> 16) & 15];
    c[4] = hex_digits[(x >> 12) & 15];
    c[5] = hex_digits[(x >> 8) & 15];
    c[6] = hex_digits[(x >> 4) & 15];
    c[7] = hex_digits[x & 15];
    return c + 8;
}

static void print_mem(char *buf, sim65 s, unsigned addr)
{
    addr &= 0xFFFF;
    if (!(s->mems[addr] & ms_invalid))
    {
        if (!(s->mems[addr] & ms_rom))
        {
            buf[0] = '[';
            hex2(buf + 1, s->mem[addr]);
            buf[3] = ']';
            buf[4] = 0;
        }
        else
        {
            buf[0] = '{';
            hex2(buf + 1, s->mem[addr]);
            buf[3] = '}';
            buf[4] = 0;
        }
    }
    else if (s->mems[addr] & ms_undef)
        memcpy(buf, "[UU]", 4);
    else
        memcpy(buf, "[NN]", 4);
}

static void print_mem_count(char *buf, sim65 s, unsigned addr, unsigned len)
{
    unsigned i;
    for (i = 0; i < len; i++)
        print_mem(buf + i * 4, s, addr + i);
}

static char *print_lbl_max(char *buf, char *lbl, int max)
{
    int ln = strlen(lbl);
    if (ln > max)
    {
        *buf++ = '?';
        memcpy(buf, lbl + ln - max + 1, max - 1);
        buf += max - 1;
    }
    else
    {
        memcpy(buf, lbl, ln);
        buf += ln;
    }
    return buf;
}

static char *print_abs_label(sim65 s, char *buf, uint16_t addr, char idx)
{
    char *l = get_label(s, addr);
    if (l && *l)
        buf = print_lbl_max(buf, l, 24);
    else
    {
        *buf++ = '$';
        buf = hex4(buf, addr);
    }
    if (idx)
    {
        *buf++ = ',';
        *buf++ = idx;
    }
    return buf;
}

static char *print_zp_label(sim65 s, char *buf, uint16_t addr, char idx)
{
    char *l = get_label(s, addr);
    if (l && *l)
        buf = print_lbl_max(buf, l, 24);
    else
    {
        *buf++ = '$';
        buf = hex2(buf, addr);
    }
    if (idx)
    {
        *buf++ = ',';
        *buf++ = idx;
    }
    return buf;
}

static char *print_ind_label(sim65 s, char *buf, uint16_t addr, char idx, int hint)
{
    char *l = get_label(s, addr);
    *buf++ = '(';
    if (l && *l)
        buf = print_lbl_max(buf, l, 14);
    else
    {
        *buf++ = '$';
        if (idx)
            buf = hex2(buf, addr);
        else
            buf = hex4(buf, addr);
    }
    if (idx == 'Y')
        *buf++ = ')';

    if (idx)
    {
        *buf++ = ',';
        *buf++ = idx;
    }

    if (idx != 'Y')
        *buf++ = ')';

    if (hint)
    {
        *buf++ = ' ';
        *buf++ = '[';
        *buf++ = '$';

        if (idx == 'X')
            buf = hex4(buf, readWord(s, 0xFF & (addr + s->r.x)));
        else if (idx == 'Y')
            buf = hex4(buf, readWord(s, addr) + s->r.y);
        else
            buf = hex4(buf, readWord(s, addr));
        *buf++ = ']';
    }

    return buf;
}

#define PSTR(str) memcpy(buf, str, strlen(str)); buf += strlen(str)
#define PHX2(val) buf = hex2(buf, val)
#define PHX4(val) buf = hex4(buf, val)
#define PNAM(name)  PSTR(name); buf++;
#define PLAB(val)  buf = print_abs_label(s, buf, val, 0)
#define PLABX(val) buf = print_abs_label(s, buf, val, 'X')
#define PLABY(val) buf = print_abs_label(s, buf, val, 'Y')
#define PLZP(val)  buf = print_zp_label(s, buf, val, 0)
#define PLZPX(val) buf = print_zp_label(s, buf, val, 'X')
#define PLZPY(val) buf = print_zp_label(s, buf, val, 'Y')
#define PLIDX(val) buf = print_ind_label(s, buf, val, 'X', hint)
#define PLIDY(val) buf = print_ind_label(s, buf, val, 'Y', hint)
#define PLIND(val) buf = print_ind_label(s, buf, val, 0, hint)
#define PXTRA(b,r,h) if (h) buf[18] = ((((b)+(r))^(b))&0xFF00) ? '*' : buf[18]

#define INSPRT_IMM(name) PNAM(name); PSTR("#$"); PHX2(data)
#define INSPRT_BRA(name) PNAM(name); PXTRA(pc+2, (int8_t)(data), 1); PLAB(pc+2+(int8_t)data)
#define INSPRT_ABS(name) PNAM(name); PLAB(data)
#define INSPRT_ABXW(name) PNAM(name); PLABX(data)
#define INSPRT_ABYW(name) PNAM(name); PLABY(data)
#define INSPRT_ABX(name) PNAM(name); PXTRA(data,s->r.x, hint); PLABX(data)
#define INSPRT_ABY(name) PNAM(name); PXTRA(data,s->r.y, hint); PLABY(data)
#define INSPRT_ZPG(name) PNAM(name); PLZP(data)
#define INSPRT_ZPX(name) PNAM(name); PLZPX(data)
#define INSPRT_ZPY(name) PNAM(name); PLZPY(data)
#define INSPRT_IDX(name) PNAM(name); PLIDX(data)
#define INSPRT_IDY(name) PNAM(name); PXTRA(readWord(s, data),s->r.y, hint); PLIDY(data)
#define INSPRT_IDYW(name) PNAM(name); PLIDY(data)
#define INSPRT_IND(name) PNAM(name); PLIND(data)
#define INSPRT_IMP(name) PNAM(name)
#define INSPRT_ACC(name) PNAM(name); PSTR("A")

static void print_curr_ins(const sim65 s, uint16_t pc, char *buf, int hint)
{
    unsigned ins = 0, data = 0, c = 0;
    ins = s->mem[pc & 0xFFFF];
    if (ilen[ins] == 2)
        data = s->mem[(1 + pc) & 0xFFFF];
    else if (ilen[ins] == 3)
        data = s->mem[(1 + pc) & 0xFFFF] + (s->mem[(2 + pc) & 0xFFFF] << 8);

    if (s->labels)
    {
        char *ebuf = buf + 19;
        char *l = get_label(s, pc);
        buf = print_lbl_max(buf, l, 16);
        if( *l )
            *buf++ = ':';
        while (buf < ebuf)
            *buf++ = ' ';
    }
    else
    {
        *buf++ = ':';
        *buf++ = ' ';
    }

    int ln = 21;
    if (s->labels)
        ln = 31;
    memset(buf, ' ', ln + 9);
    buf[ln] = ';';
    c = ilen[ins];
    print_mem_count(buf + ln + 2, s, pc, c);
    buf[ln + 2 + c * 4] = 0;

    switch (ins)
    {
        case 0x00: INSPRT_IMP("BRK"); break;
        case 0x01: INSPRT_IDX("ORA"); break;
        case 0x02: INSPRT_IMP("kil"); break;
        case 0x03: INSPRT_IDYW("slo"); break;
        case 0x04: INSPRT_ZPG("dop"); break;
        case 0x05: INSPRT_ZPG("ORA"); break;
        case 0x06: INSPRT_ZPG("ASL"); break;
        case 0x07: INSPRT_ZPG("slo"); break;
        case 0x08: INSPRT_IMP("PHP"); break;
        case 0x09: INSPRT_IMM("ORA"); break;
        case 0x0A: INSPRT_ACC("ASL"); break;
        case 0x0B: INSPRT_IMM("aac"); break;
        case 0x0C: INSPRT_ABS("top"); break;
        case 0x0D: INSPRT_ABS("ORA"); break;
        case 0x0E: INSPRT_ABS("ASL"); break;
        case 0x0F: INSPRT_ABS("slo"); break;
        case 0x10: INSPRT_BRA("BPL"); break;
        case 0x11: INSPRT_IDY("ORA"); break;
        case 0x12: INSPRT_IMP("kil"); break;
        case 0x13: INSPRT_IDX("slo"); break;
        case 0x14: INSPRT_ZPX("dop"); break;
        case 0x15: INSPRT_ZPX("ORA"); break;
        case 0x16: INSPRT_ZPX("ASL"); break;
        case 0x17: INSPRT_ZPX("slo"); break;
        case 0x18: INSPRT_IMP("CLC"); break;
        case 0x19: INSPRT_ABY("ORA"); break;
        case 0x1A: INSPRT_IMP("nop"); break;
        case 0x1B: INSPRT_ABY("slo"); break;
        case 0x1C: INSPRT_ABX("top"); break;
        case 0x1D: INSPRT_ABX("ORA"); break;
        case 0x1E: INSPRT_ABXW("ASL"); break;
        case 0x1F: INSPRT_ABXW("slo"); break;
        case 0x20: INSPRT_ABS("JSR"); break;
        case 0x21: INSPRT_IDX("AND"); break;
        case 0x22: INSPRT_IMP("kil"); break;
        case 0x23: INSPRT_IDX("rla"); break;
        case 0x24: INSPRT_ZPG("BIT"); break;
        case 0x25: INSPRT_ZPG("AND"); break;
        case 0x26: INSPRT_ZPG("ROL"); break;
        case 0x27: INSPRT_ZPG("rla"); break;
        case 0x28: INSPRT_IMP("PLP"); break;
        case 0x29: INSPRT_IMM("AND"); break;
        case 0x2A: INSPRT_ACC("ROL"); break;
        case 0x2B: INSPRT_IMM("aac"); break;
        case 0x2C: INSPRT_ABS("BIT"); break;
        case 0x2D: INSPRT_ABS("AND"); break;
        case 0x2E: INSPRT_ABS("ROL"); break;
        case 0x2F: INSPRT_ABS("rla"); break;
        case 0x30: INSPRT_BRA("BMI"); break;
        case 0x31: INSPRT_IDY("AND"); break;
        case 0x32: INSPRT_IMP("kil"); break;
        case 0x33: INSPRT_IDYW("rla"); break;
        case 0x34: INSPRT_ZPX("dop"); break;
        case 0x35: INSPRT_ZPX("AND"); break;
        case 0x36: INSPRT_ZPX("ROL"); break;
        case 0x37: INSPRT_ZPX("rla"); break;
        case 0x38: INSPRT_IMP("SEC"); break;
        case 0x39: INSPRT_ABY("AND"); break;
        case 0x3A: INSPRT_IMP("nop"); break;
        case 0x3B: INSPRT_ABYW("rla"); break;
        case 0x3C: INSPRT_ABX("top"); break;
        case 0x3D: INSPRT_ABX("AND"); break;
        case 0x3E: INSPRT_ABXW("ROL"); break;
        case 0x3F: INSPRT_ABXW("rla"); break;
        case 0x40: INSPRT_IMP("RTI"); break;
        case 0x41: INSPRT_IDX("EOR"); break;
        case 0x42: INSPRT_IMP("kil"); break;
        case 0x43: INSPRT_IDX("sre"); break;
        case 0x44: INSPRT_ZPG("dop"); break;
        case 0x45: INSPRT_ZPG("EOR"); break;
        case 0x46: INSPRT_ZPG("LSR"); break;
        case 0x47: INSPRT_ZPG("sre"); break;
        case 0x48: INSPRT_IMP("PHA"); break;
        case 0x49: INSPRT_IMM("EOR"); break;
        case 0x4A: INSPRT_ACC("LSR"); break;
        case 0x4B: INSPRT_IMM("asr"); break;
        case 0x4C: INSPRT_ABS("JMP"); break;
        case 0x4D: INSPRT_ABS("EOR"); break;
        case 0x4E: INSPRT_ABS("LSR"); break;
        case 0x4F: INSPRT_ABS("sre"); break;
        case 0x50: INSPRT_BRA("BVC"); break;
        case 0x51: INSPRT_IDY("EOR"); break;
        case 0x52: INSPRT_IMP("kil"); break;
        case 0x53: INSPRT_IDYW("sre"); break;
        case 0x54: INSPRT_ZPX("dop"); break;
        case 0x55: INSPRT_ZPX("EOR"); break;
        case 0x56: INSPRT_ZPX("LSR"); break;
        case 0x57: INSPRT_ZPX("sre"); break;
        case 0x58: INSPRT_IMP("CLI"); break;
        case 0x59: INSPRT_ABY("EOR"); break;
        case 0x5A: INSPRT_IMP("nop"); break;
        case 0x5B: INSPRT_ABYW("sre"); break;
        case 0x5C: INSPRT_ABX("top"); break;
        case 0x5D: INSPRT_ABX("EOR"); break;
        case 0x5E: INSPRT_ABXW("LSR"); break;
        case 0x5F: INSPRT_ABXW("sre"); break;
        case 0x60: INSPRT_IMP("RTS"); break;
        case 0x61: INSPRT_IDX("ADC"); break;
        case 0x62: INSPRT_IMP("kil"); break;
        case 0x63: INSPRT_IDX("rra"); break;
        case 0x64: INSPRT_ZPG("dop"); break;
        case 0x65: INSPRT_ZPG("ADC"); break;
        case 0x66: INSPRT_ZPG("ROR"); break;
        case 0x67: INSPRT_ZPG("rra"); break;
        case 0x68: INSPRT_IMP("PLA"); break;
        case 0x69: INSPRT_IMM("ADC"); break;
        case 0x6A: INSPRT_ACC("ROR"); break;
        case 0x6B: INSPRT_IMM("arr"); break;
        case 0x6C: INSPRT_IND("JMP"); break;
        case 0x6D: INSPRT_ABS("ADC"); break;
        case 0x6E: INSPRT_ABS("ROR"); break;
        case 0x6F: INSPRT_ABS("rra"); break;
        case 0x70: INSPRT_BRA("BVS"); break;
        case 0x71: INSPRT_IDY("ADC"); break;
        case 0x72: INSPRT_IMP("kil"); break;
        case 0x73: INSPRT_IDYW("rra"); break;
        case 0x74: INSPRT_ZPX("dop"); break;
        case 0x75: INSPRT_ZPX("ADC"); break;
        case 0x76: INSPRT_ZPX("ROR"); break;
        case 0x77: INSPRT_ZPX("rra"); break;
        case 0x78: INSPRT_IMP("SEI"); break;
        case 0x79: INSPRT_ABY("ADC"); break;
        case 0x7A: INSPRT_IMP("nop"); break;
        case 0x7B: INSPRT_ABYW("rra"); break;
        case 0x7C: INSPRT_ABX("top"); break;
        case 0x7D: INSPRT_ABX("ADC"); break;
        case 0x7E: INSPRT_ABXW("ROR"); break;
        case 0x7F: INSPRT_ABXW("rra"); break;
        case 0x80: INSPRT_IMM("dop"); break;
        case 0x81: INSPRT_IDX("STA"); break;
        case 0x82: INSPRT_IMM("dop"); break;
        case 0x83: INSPRT_IDX("aax"); break;
        case 0x84: INSPRT_ZPG("STY"); break;
        case 0x85: INSPRT_ZPG("STA"); break;
        case 0x86: INSPRT_ZPG("STX"); break;
        case 0x87: INSPRT_ZPG("aax"); break;
        case 0x88: INSPRT_IMP("DEY"); break;
        case 0x89: INSPRT_IMM("dop"); break;
        case 0x8A: INSPRT_IMP("TXA"); break;
        case 0x8B: INSPRT_IMM("xaa"); break;
        case 0x8C: INSPRT_ABS("STY"); break;
        case 0x8D: INSPRT_ABS("STA"); break;
        case 0x8E: INSPRT_ABS("STX"); break;
        case 0x8F: INSPRT_ABS("aax"); break;
        case 0x90: INSPRT_BRA("BCC"); break;
        case 0x91: INSPRT_IDYW("STA"); break;
        case 0x92: INSPRT_IMP("kil"); break;
        case 0x93: INSPRT_IDYW("axa"); break;
        case 0x94: INSPRT_ZPX("STY"); break;
        case 0x95: INSPRT_ZPX("STA"); break;
        case 0x96: INSPRT_ZPY("STX"); break;
        case 0x97: INSPRT_ZPX("aax"); break;
        case 0x98: INSPRT_IMP("TYA"); break;
        case 0x99: INSPRT_ABYW("STA"); break;
        case 0x9A: INSPRT_IMP("TXS"); break;
        case 0x9B: INSPRT_ABYW("xas"); break;
        case 0x9C: INSPRT_ABXW("sya"); break;
        case 0x9D: INSPRT_ABXW("STA"); break;
        case 0x9E: INSPRT_ABYW("sxa"); break;
        case 0x9F: INSPRT_ABYW("axa"); break;
        case 0xA0: INSPRT_IMM("LDY"); break;
        case 0xA1: INSPRT_IDX("LDA"); break;
        case 0xA2: INSPRT_IMM("LDX"); break;
        case 0xA3: INSPRT_IDX("lax"); break;
        case 0xA4: INSPRT_ZPG("LDY"); break;
        case 0xA5: INSPRT_ZPG("LDA"); break;
        case 0xA6: INSPRT_ZPG("LDX"); break;
        case 0xA7: INSPRT_ZPG("lax"); break;
        case 0xA8: INSPRT_IMP("TAY"); break;
        case 0xA9: INSPRT_IMM("LDA"); break;
        case 0xAA: INSPRT_IMP("TAX"); break;
        case 0xAB: INSPRT_IMP("atx"); break;
        case 0xAC: INSPRT_ABS("LDY"); break;
        case 0xAD: INSPRT_ABS("LDA"); break;
        case 0xAE: INSPRT_ABS("LDX"); break;
        case 0xAF: INSPRT_ABS("lax"); break;
        case 0xB0: INSPRT_BRA("BCS"); break;
        case 0xB1: INSPRT_IDY("LDA"); break;
        case 0xB2: INSPRT_IMP("kil"); break;
        case 0xB3: INSPRT_IDY("lax"); break;
        case 0xB4: INSPRT_ZPX("LDY"); break;
        case 0xB5: INSPRT_ZPX("LDA"); break;
        case 0xB6: INSPRT_ZPY("LDX"); break;
        case 0xB7: INSPRT_ZPX("lax"); break;
        case 0xB8: INSPRT_IMP("CLV"); break;
        case 0xB9: INSPRT_ABY("LDA"); break;
        case 0xBA: INSPRT_IMP("TSX"); break;
        case 0xBB: INSPRT_ABY("lar"); break;
        case 0xBC: INSPRT_ABX("LDY"); break;
        case 0xBD: INSPRT_ABX("LDA"); break;
        case 0xBE: INSPRT_ABY("LDX"); break;
        case 0xBF: INSPRT_ABY("lax"); break;
        case 0xC0: INSPRT_IMM("CPY"); break;
        case 0xC1: INSPRT_IDX("CMP"); break;
        case 0xC2: INSPRT_IMM("dop"); break;
        case 0xC3: INSPRT_IDX("dcp"); break;
        case 0xC4: INSPRT_ZPG("CPY"); break;
        case 0xC5: INSPRT_ZPG("CMP"); break;
        case 0xC6: INSPRT_ZPG("DEC"); break;
        case 0xC7: INSPRT_ZPG("dcp"); break;
        case 0xC8: INSPRT_IMP("INY"); break;
        case 0xC9: INSPRT_IMM("CMP"); break;
        case 0xCA: INSPRT_IMP("DEX"); break;
        case 0xCB: INSPRT_IMM("axs"); break;
        case 0xCC: INSPRT_ABS("CPY"); break;
        case 0xCD: INSPRT_ABS("CMP"); break;
        case 0xCE: INSPRT_ABS("DEC"); break;
        case 0xCF: INSPRT_ABS("dcp"); break;
        case 0xD0: INSPRT_BRA("BNE"); break;
        case 0xD1: INSPRT_IDY("CMP"); break;
        case 0xD2: INSPRT_IMP("kil"); break;
        case 0xD3: INSPRT_IDYW("dcp"); break;
        case 0xD4: INSPRT_ZPX("dop"); break;
        case 0xD5: INSPRT_ZPX("CMP"); break;
        case 0xD6: INSPRT_ZPX("DEC"); break;
        case 0xD7: INSPRT_ZPX("dcp"); break;
        case 0xD8: INSPRT_IMP("CLD"); break;
        case 0xD9: INSPRT_ABY("CMP"); break;
        case 0xDA: INSPRT_IMP("nop"); break;
        case 0xDB: INSPRT_ABYW("dcp"); break;
        case 0xDC: INSPRT_ABX("top"); break;
        case 0xDD: INSPRT_ABX("CMP"); break;
        case 0xDE: INSPRT_ABXW("DEC"); break;
        case 0xDF: INSPRT_ABXW("dcp"); break;
        case 0xE0: INSPRT_IMM("CPX"); break;
        case 0xE1: INSPRT_IDX("SBC"); break;
        case 0xE2: INSPRT_IMM("dop"); break;
        case 0xE3: INSPRT_IDX("isc"); break;
        case 0xE4: INSPRT_ZPG("CPX"); break;
        case 0xE5: INSPRT_ZPG("SBC"); break;
        case 0xE6: INSPRT_ZPG("INC"); break;
        case 0xE7: INSPRT_ZPG("isc"); break;
        case 0xE8: INSPRT_IMP("INX"); break;
        case 0xE9: INSPRT_IMM("SBC"); break;
        case 0xEA: INSPRT_IMP("NOP"); break;
        case 0xEB: INSPRT_IMM("sbc"); break;
        case 0xEC: INSPRT_ABS("CPX"); break;
        case 0xED: INSPRT_ABS("SBC"); break;
        case 0xEE: INSPRT_ABS("INC"); break;
        case 0xEF: INSPRT_ABS("isc"); break;
        case 0xF0: INSPRT_BRA("BEQ"); break;
        case 0xF1: INSPRT_IDY("SBC"); break;
        case 0xF2: INSPRT_IMP("kil"); break;
        case 0xF3: INSPRT_IDYW("isc"); break;
        case 0xF4: INSPRT_ZPX("dop"); break;
        case 0xF5: INSPRT_ZPX("SBC"); break;
        case 0xF6: INSPRT_ZPX("INC"); break;
        case 0xF7: INSPRT_ZPX("isc"); break;
        case 0xF8: INSPRT_IMP("SED"); break;
        case 0xF9: INSPRT_ABY("SBC"); break;
        case 0xFA: INSPRT_IMP("nop"); break;
        case 0xFB: INSPRT_ABYW("isc"); break;
        case 0xFC: INSPRT_ABX("top"); break;
        case 0xFD: INSPRT_ABX("SBC"); break;
        case 0xFE: INSPRT_ABXW("INC"); break;
        case 0xFF: INSPRT_ABXW("isc"); break;
    }
}

void sim65_print_reg(const sim65 s, FILE *f)
{
    char buffer[256];
    char *buf = buffer;
    buf = hex8(buf, s->cycles);
    PSTR(": A=");
    PHX2(s->r.a);
    PSTR(" X=");
    PHX2(s->r.x);
    PSTR(" Y=");
    PHX2(s->r.y);
    PSTR(" P=");
    PHX2(s->r.p);
    PSTR(" S=");
    PHX2(s->r.s);
    PSTR(" PC=");
    PHX4(s->r.pc);
    *buf++ = ' ';
    print_curr_ins(s, s->r.pc, buf, 1);
    fputs(buffer, f);
    putc('\n', f);
}

char * sim65_disassemble(const sim65 s, char *buf, uint16_t addr)
{
    print_curr_ins(s, addr, buf, 0);
    return buf;
}

int sim65_dprintf(sim65 s, const char *format, ...)
{
    char buf[1024];
    int size;
    va_list ap;

    if (s->debug >= sim65_debug_messages)
    {
        // Print original message to a string
        va_start(ap, format);
        vsnprintf(buf, 1024, format, ap);
        va_end(ap);
        // Print to stderr always
        if (s->debug < sim65_debug_trace || s->trace_file != stderr)
            size = fprintf(stderr, "sim65: %s\n", buf);
        // And print to trace file, if trace is active
        if (s->debug >= sim65_debug_trace)
            size = fprintf(s->trace_file, "%08" PRIX64 ": %s\n", s->cycles, buf);
    }
    else
        size = 0;
    return size;
}

int sim65_eprintf(sim65 s, const char *format, ...)
{
    char buf[1024];
    int size;
    va_list ap;
    va_start(ap, format);
    vsnprintf(buf, 1024, format, ap);
    va_end(ap);
    if (s->debug < sim65_debug_trace || s->trace_file != stderr)
        size = fprintf(stderr, "sim65: ERROR, %s\n", buf);
    if (s->debug >= sim65_debug_trace)
        size = fprintf(s->trace_file, "%08" PRIX64 ": ERROR, %s\n", s->cycles, buf);
    return size;
}

uint16_t sim65_error_addr(sim65 s)
{
    return s->err_addr;
}

const char *sim65_error_str(sim65 s, enum sim65_error e)
{
    const char *err[1-sim65_err_user] = {
        "no error",
        "instruction read from undefined memory",
        "instruction read from uninitialized memory",
        "read from undefined memory",
        "read from uninitialized memory",
        "write to undefined memory",
        "write to read-only memory",
        "BRK instruction executed",
        "invalid instruction executed",
        "return from emulator",
        "cycle limit reached",
        "user defined error"
    };

    if (e > sim65_err_none)
        e = sim65_err_none;
    else if (e < sim65_err_user)
        e = sim65_err_user;
    return err[-e];

}

void sim65_lbl_add(sim65 s, uint16_t addr, const char *lbl)
{
    // Ignore empty labels
    if (!lbl || !*lbl)
        return;
    // Allocate labels if not already done
    if (!s->labels)
        s->labels = (char *)calloc(65536, 32);
    strncpy( get_label(s, addr), lbl, 31);
}

int sim65_lbl_load(sim65 s, const char *lblname)
{
    int line = 0;
    FILE *f = fopen(lblname, "r");
    if (!f)
        return -1;
    while (1)
    {
        char name[32], str[256];
        unsigned addr = 0, page = 0;
        int e = fscanf(f, "%255[^\n\r]\n", str);
        if (e == EOF)
            break;
        line ++;
        // Try parsing a CC65 line:
        if (2 != sscanf(str, "al %6x .%31s", &addr, name))
        {
            // No, try parsing MADS line:
            if (3 != sscanf(str, "%02x %04x %31s", &page, &addr, name))
            {
                // Ignore line
                sim65_eprintf(s, "%s[%d]: invalid line on label file", lblname, line);
                continue;
            }
        }
        if (addr <= 0xFFFF && page == 0)
            sim65_lbl_add(s, addr, name);
    }
    fclose(f);
    return 0;
}

uint64_t sim65_get_cycles(const sim65 s)
{
    return s->cycles;
}

struct sim65_profile sim65_get_profile_info(const sim65 s)
{
    struct sim65_profile r;
    r.exe_count = s->prof.exe;
    r.branch_taken = s->prof.branch;
    r.total.branch_skip = s->prof.branch_skip;
    r.total.branch_taken = s->prof.branch_taken;
    r.total.branch_extra = s->prof.branch_extra;
    r.total.instructions = s->prof.instructions;
    r.total.cycles = s->cycles;
    r.total.extra_abs_x = s->prof.abs_x_extra;
    r.total.extra_abs_y = s->prof.abs_y_extra;
    r.total.extra_ind_y = s->prof.ind_y_extra;
    return r;
}

void sim65_set_profiling(const sim65 s, int set)
{
    s->do_prof = set;
}

const char *sim65_get_label(const sim65 s, uint16_t addr)
{
    return get_label(s, addr);
}
