dmsc/my6502/tests/timer_tb.v

/*
 * Simple 6502 computer for ice40up5k FPGA.
 *
 * (C) Daniel Serpell, <daniel.serpell@gmail.com>
 *
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
 */

// Test module for timer module

`define check(signal, value) \
    if (signal !== value) begin \
        $display("ASSERTION FAILED t=%t: signal != value  [%h]", $time, signal); \
        $finish; \
    end

`define write(value, xaddr) \
    @(negedge clk); \
    dbw = value; \
    addr = xaddr; \
    we  = 1; \
    # 2 \
    we = 0; \
    dbw = 0;

`define read_chk(value, xaddr) \
    @(negedge clk); \
    addr = xaddr; \
    we  = 0; \
    # 2 \
    `check(dbr, value); \
    we = 0; \

module test;

  /* Make a regular pulsing clock. */
  reg clk = 0;
  always #1 clk = !clk;

  reg we, rst;
  reg [1:0] addr;
  reg [7:0] dbw;
  wire [7:0] dbr;


  initial begin
     string vcd_file;
     if (!$value$plusargs("vcd=%s", vcd_file)) begin
         $display("Specify output VCD file with +vcd=<file>.");
         $finish_and_return(1);
     end
     $dumpfile(vcd_file);
     $dumpvars(0,test);
     rst = 0;
     we = 0;
     dbw = 8'b0;
     addr = 0;
     # 7
     rst = 1;
     # 9
     rst = 0;
     # 8
 //    `check(dbr, 0);
     # 16
     `write(   0, 2 );  // disable timer
     `write( 232, 0 );  // Set limit == 1000
     `write(   3, 1 );
     `write(   1, 2 );  // enable timer
     # 1400
     `read_chk(8'b1, 2);
     # 596
     `read_chk(8'b1, 2);
     # 2
     `read_chk(8'b10000001, 2);
     # 78
     `write(  98, 0 );  // Set limit == 100
     `write(   0, 1 );
     `write(   1, 2 );
     # 110
     `read_chk(8'b00000001, 2);
     # 2
     `read_chk(8'b10000001, 2);
     # 100
     `write(   0, 2 );
     `write( 100, 0 );  // Set limit == 100
     `write(   0, 0 );
     `write(   1, 2 );
     # 200
     `read_chk(8'b00000001, 2);
     # 2
     `read_chk(8'b10000001, 2);
     # 10 $finish;
  end

  timer timer1 (
      .dbr(dbr),
      .dbw(dbw),
      .addr(addr),
      .we(we),
      .rst(rst),
      .clk(clk)
  );

  initial
     $monitor("At time %5d, [%h %h %b] A:%b S:%b", $time, dbr, dbw, we, timer1.active, timer1.shot);

endmodule // test
