dmsc/my6502/(commit log)

2018-11-10 First UART.
2018-11-13 Adds timer.
2018-11-13 Adds timer test to makefile.
2018-11-16 Simplify read/write logic, devices should latch address.
2018-11-18 Rewrite UART to use only non-blocking assignments.
    Old code gave different results in simulation versus synthesis.
2018-11-18 Build main upduino board module.
2018-11-18 Use a bigger value for the timer.
    In real CPU write a message each 100ms.
2018-11-19 Implements UART receiving.
2018-11-25 Simplify timer, don't rely on blocking assignments.
2018-11-28 Fixes to the UART, latching RX is necessary to avoid invalid states.
    [uart.v]
2018-11-29 Adds RGB led module, at address $FE40.
2018-11-29 Optimize a few bytes from minirom, blink leds on input.
2018-12-27 Fixes undefined "lock" wire.
    [upduino.v]
2019-07-23 Simplify monitor, shorter and faster initialization.
    Remove timeouts in serial input, not really needed.
    [minirom.asm]
2019-08-15 Adds simple SPI peripheral and tries to boot from the SPI flash.
2019-09-20 Write label file from assembler.
2019-10-02 Simplify timer module.
2019-10-02 Implement vertical blank and horizontal line interrupts.
2019-10-07 Fix compilation under icarus-verilog.
    [ps2.v]
2019-10-13 Use >= to compare ending of font line.
    This fixes changing VGA mode at mid screen.
    [vga.v]
2019-10-13 Add support for VGA interrupts to the firmware.
